mihirsavadi/choreChartTracker/pics_vids/badi2c_1.png

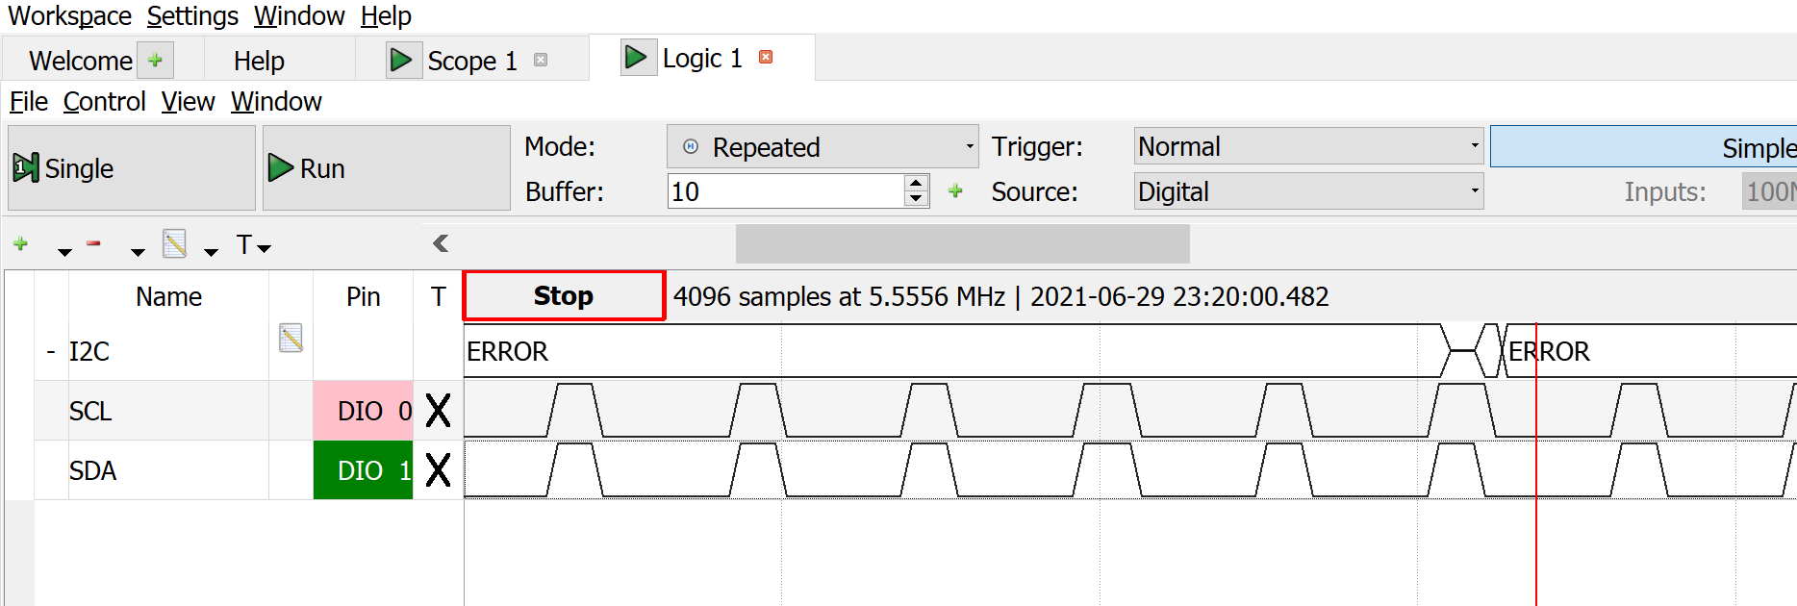
pics_vids/badi2c_1.png
