mihirsavadi/choreChartTracker/pics_vids/badi2c_2.png

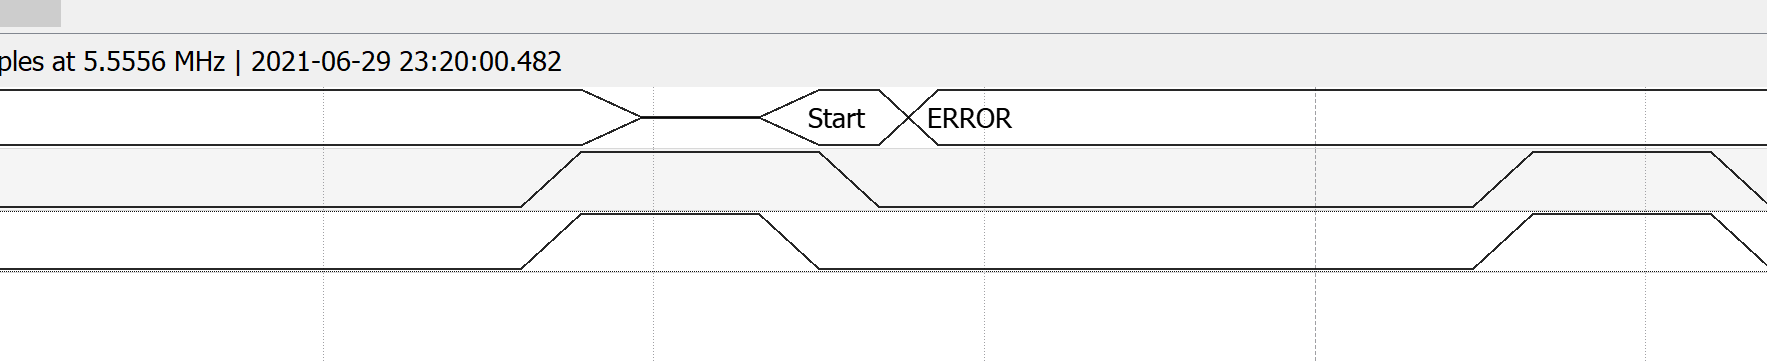
pics_vids/badi2c_2.png
