mihirsavadi/choreChartTracker/pics_vids/badi2c_3.png

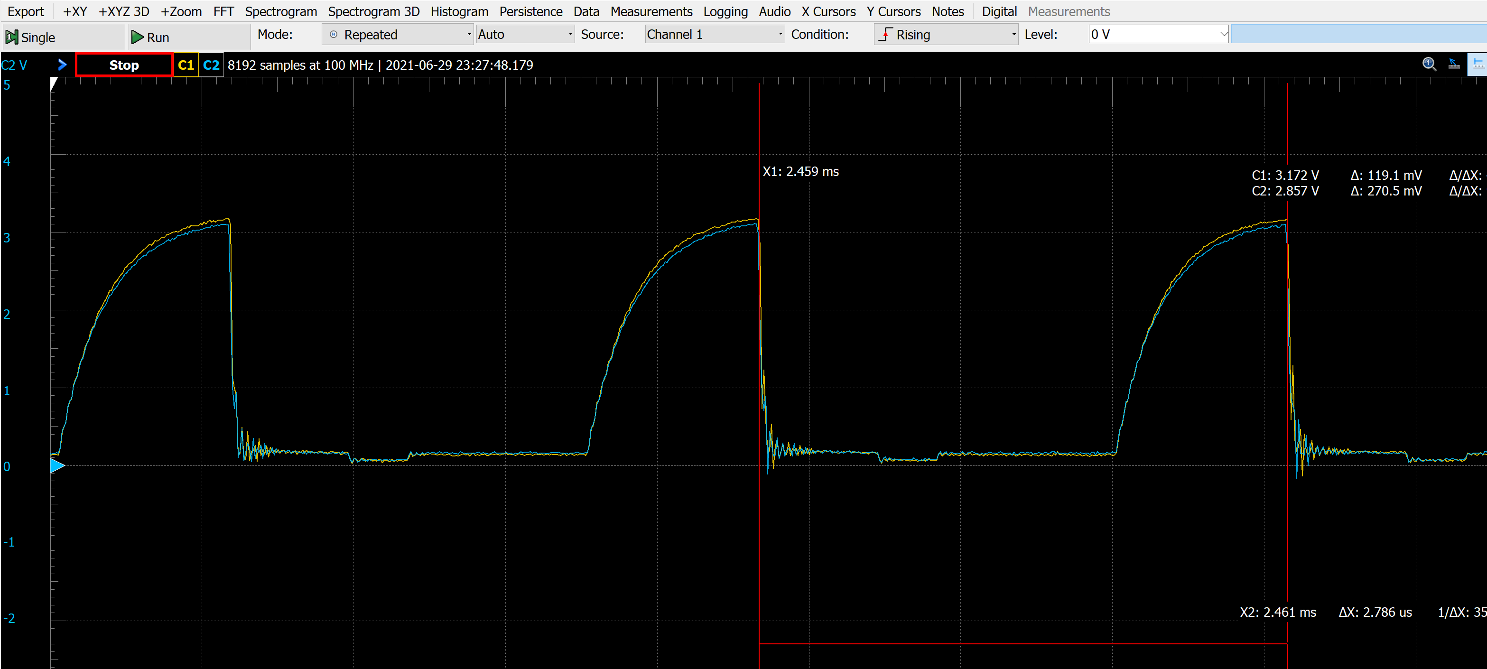
pics_vids/badi2c_3.png
