mihirsavadi/choreChartTracker/pics_vids/boardbottom_hw_rev1.jpg

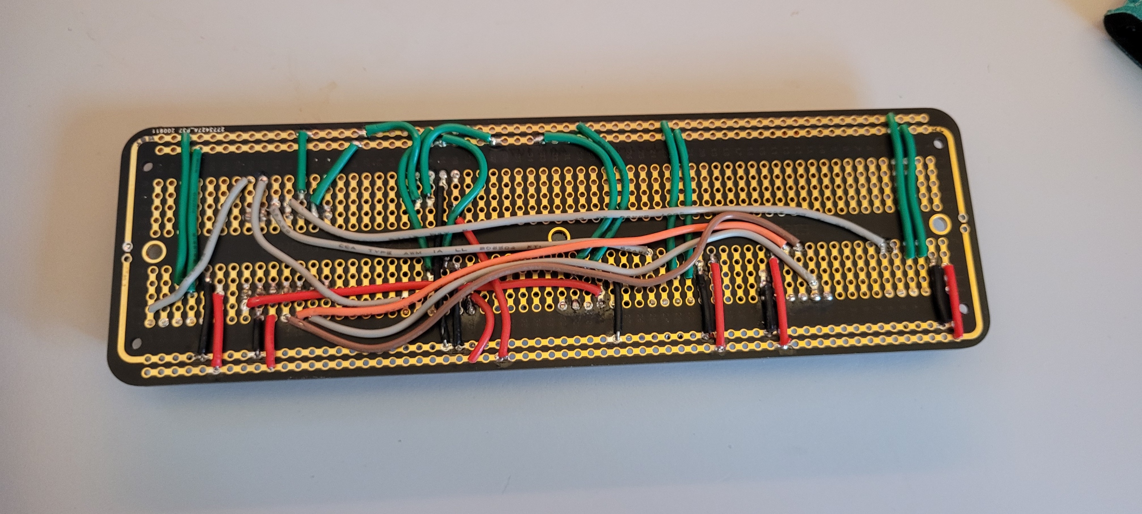
pics_vids/boardbottom_hw_rev1.jpg
