mihirsavadi/choreChartTracker/pics_vids/boardfrontish_hw_rev1.jpg

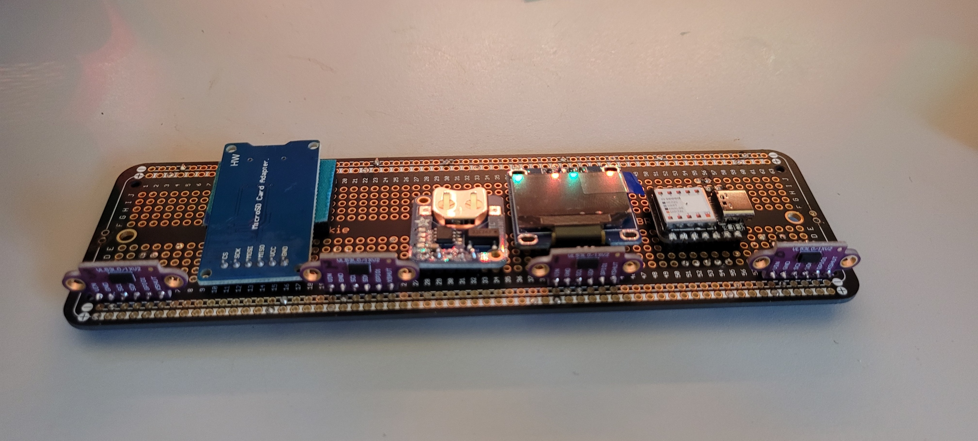
pics_vids/boardfrontish_hw_rev1.jpg
