mihirsavadi/choreChartTracker/pics_vids/boardtop_hw_rev1.jpg

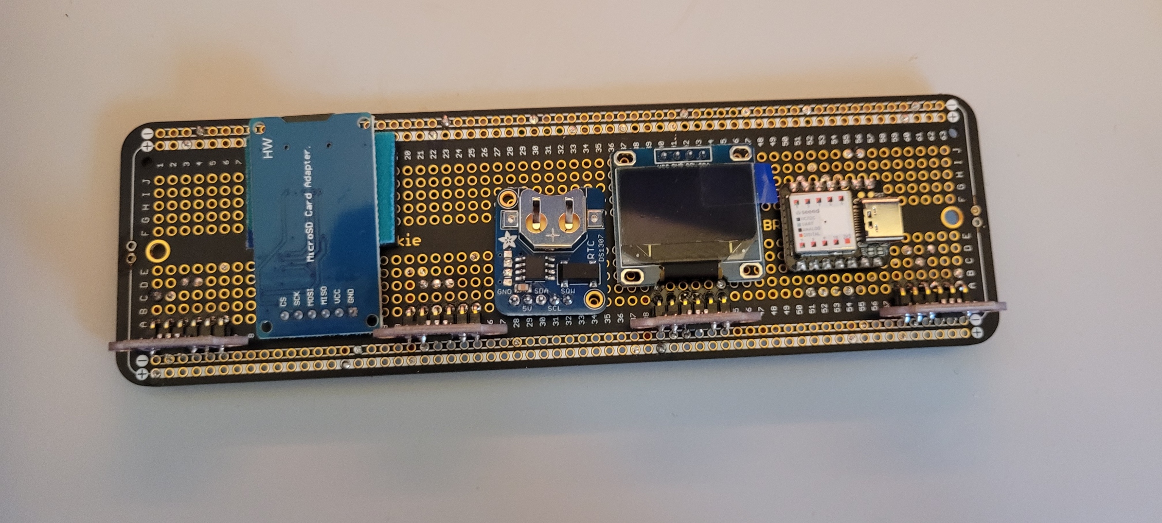
pics_vids/boardtop_hw_rev1.jpg
