mihirsavadi/choreChartTracker/hardware/choreChartTracker_hardware_rev3/choreChartTracker_rev3_schematic.pdf

# Adafruit

DS3231

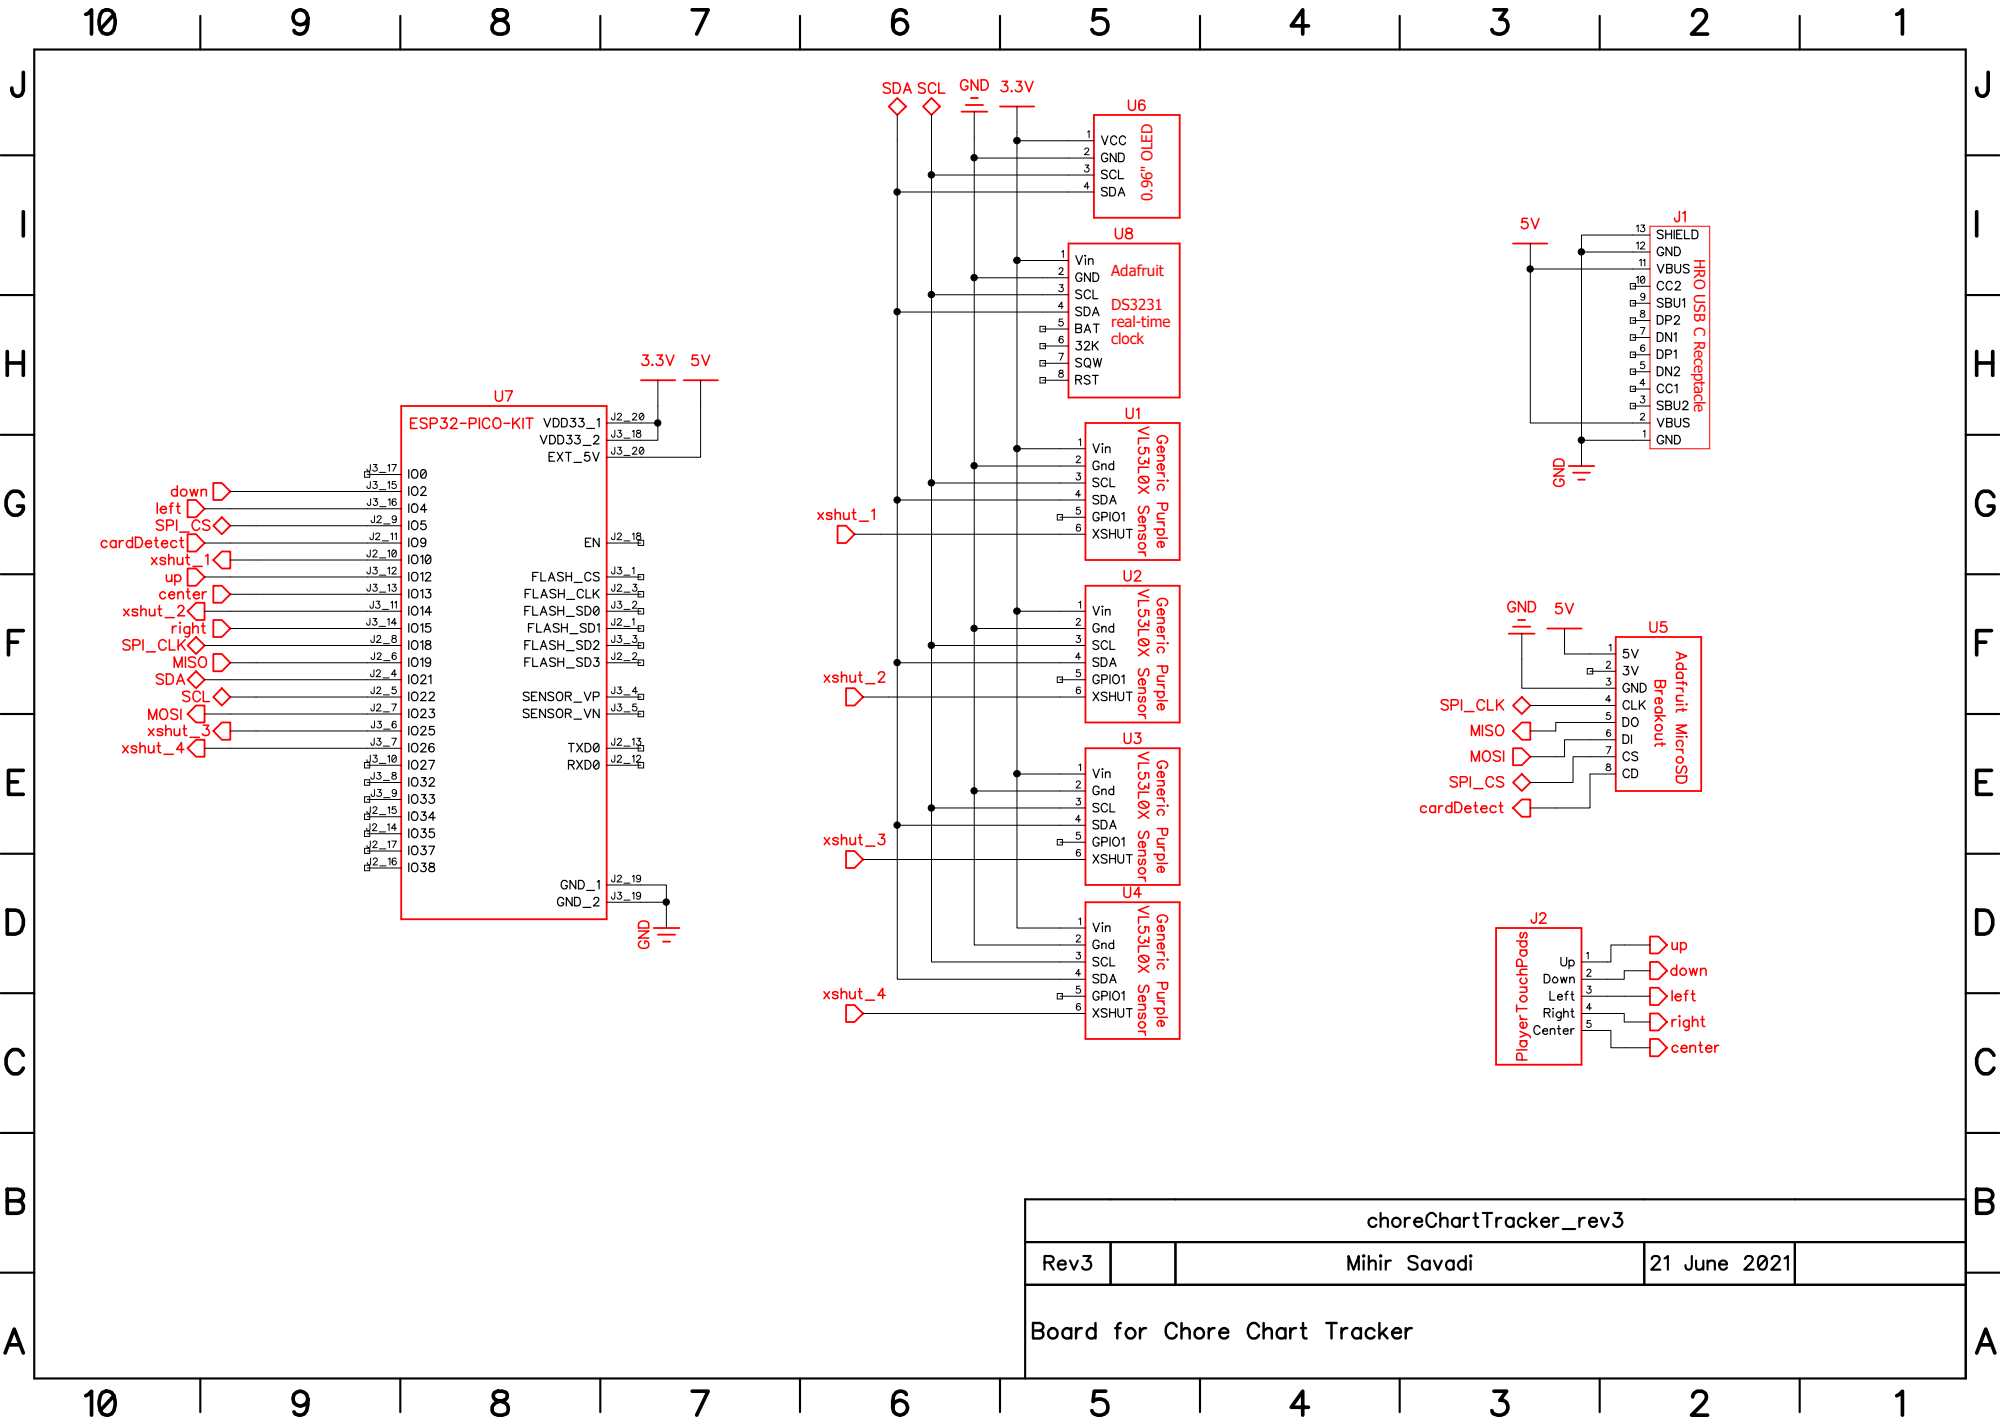
[picture p10: page 1]
real-time clock

HRO USB C Receptacle 0.96" OLED
