mihirsavadi/choreChartTracker/(list of files, drawings)

Other design files:
hardware/choreChartTracker_hardware_rev2/choreChartTracker_rev2_pcb.dip
hardware/choreChartTracker_hardware_rev2/choreChartTracker_rev2_schematic.dch
hardware/choreChartTracker_hardware_rev3/choreChartTracker_rev3_pcb.dip
hardware/choreChartTracker_hardware_rev3/choreChartTracker_rev3_schematic.dch
