mihirsavadi/choreChartTracker/(commit log)

2021-04-14 added more into constructor, linking issue still not fied
    [main.cpp]
2021-04-14 for some reason pio linker wont include lib files so moved all custom libraries under the source folder. after doing this compiler found my choreChartTracker.cpp and gave me a bunch of errors that I 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
    [main.cpp]
2021-04-15 figured out vl53l0x sensor code and feeding to oled
2021-04-15 saved working code for tof sensor
2021-04-15 bricked seeed xiao by using std libraries esp vector string and algos. when removed constructor from main, after ruploading to board in dfu mode via stock arduino ide code works again. will rework ev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
    [main.cpp]
2021-04-15 changed all std::string types to arduino specific String
2021-04-16 fixed a bunch of stuff, had to change a ton of things. What matters is multiple ToF now work perfectly including constructors and fetching data. This commit marks perfect function of ToF sensors. Lef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
    [main.cpp]
2021-05-26 created new revision 2 hardware, with ESP32, capactive touch navigation buttons, and PCB consolidation
    [choreChartTracker.dch, choreChartTracker_rev2_pcb.dip, choreChartTracker_rev2_schematic.dch]
2021-05-26 renamed software directory to rev1 and made a new rev2 directory for new pio project for esp32 pico kit target board
2021-05-28 hardware rev2 pcb rendering pics
2021-05-31 copy pasted code from rev1 into rev2. Still need to modify for esp32 compatibility and restructure class architecture for wifi/bluetooth implementation
2021-06-05 removed all RTC dependencies for fetching date and time cos rev2 doesnt have an RTC module cos I forgot to put one in cos im an idiot, but we can fetch time and data from a wifi connection w internet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
2021-06-06 fixed all libraries and dependencies for esp32 pico kit. everything compiles fine now
2021-06-06 completely changed structure to use arduino ide instead of platform io. see top of software notes in root README
    [board.dxf, clock.dxf, clock_2.dxf, clock_cube.dxf, display.csv, hx1230_commands.ods]
2021-06-07 updated hardware notes, rev2 big screw up
2021-06-21 made new hardware rev3 to fix i2c bus trace transmission issues
    [board.dxf, choreChartTracker_rev2_pcb.dip, choreChartTracker_rev2_schematic.dch, clock.dxf, clock_2.dxf, clock_cube.dxf, display.csv, hx1230_commands.ods]
2021-07-02 added issues log for rev3 hardware. moving back to solderable breadboard
2021-07-08 completely redid rev2 software layout. still lots of todos left, but somewhat workng with esp32 pico
    [board.dxf, clock.dxf, clock_2.dxf, clock_cube.dxf, display.csv, hx1230_commands.ods]
2021-07-08 some schematic bumfuggery
    [choreChartTracker_rev3_schematic.dch]
2021-07-12 all peripherals operational. Added a shit ton of error handling functionality
    [main.cpp]
2021-07-12 integrated choredoer and chorename detection and logging functionality using sensor inputs
2021-07-12 integrated code completely. Everything up as per spec. Only have google sheets and wifi integration left to do, as well as vl53l0x real time health checking and error reporting - neither are critical
    [main.cpp]
2021-07-12 fixed some display and chordoer logic bumfuggery
    [main.cpp]
2021-07-12 added pics n vids about the i2c stuff, hw rev4 pics, and cleaned up names
2021-07-12 big phat i2c problems vid
